wenke-chen/DM-segway/电气接线图.png

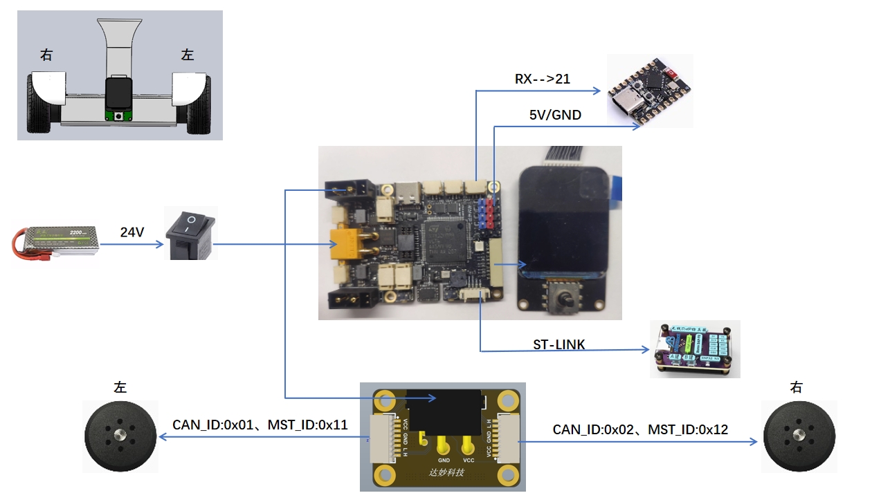
电气接线图.png
