wenke-chen/DM-segway/README.md

演示视频：[小米九号平衡车mini版](https://www.bilibili.com/video/BV1ERuzzHEXi/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)

相关教程：https://wenke-chen.github.io/p/segway/
