wenke-chen/DM-segway/DM-car-lqr/遥控说明.txt

esp32-c3mini参考：https://github.com/xiaocainiao11111/ESP32_connect_XboxController
接线： 21-->rx
