wenke-chen/DM-segway/平衡车BOM.xlsx

序号 | 物料类型 | 物料名称 | 物料型号 | 物料示意图 | 参数说明 | 单价 | 数量 | 总价 | 购买链接 | 备注
1 | 电子件 | 开发板 | DM_MC02 |  | 主控+LCD模块 | 235 | 1 | 235 | https://item.taobao.com/item.htm?id=814954787248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
2 | 电子件 | XT30 2+2 线缆 | XT30 2+2 |  | 200mm | 12 | 1 | 12 | https://item.taobao.com/item.htm?id=815810342495&skuId=5683518279285
3 | 电子件 | 转接板1 | 2×sh1.0-8pin转xt30 2+2 |  |  |  | 1 | 0 |  | 自己打板
4 | 电子件 | 转接板2 | sh1.0-3pin+8pin转xt30+gh1.25 |  |  |  | 1 | 0 | https://item.taobao.com/item.htm?abbucket=17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 | 转接板2用于上位机与电机单独调试
5 | 电子件 | 6s电池 | 1100ma/h 30C |  |  | 63 | 1 | 63 | https://item.taobao.com/item.htm?_u=b3gud67l3a33&id=527326501663&skuId=4922250528308 | 自备充电器
6 | 电子件 | ESP32-C3开发板 | ESP32-C3开发板 |  | wifi+蓝牙模块 4M闪存 | 11 | 1 | 11 | https://detail.tmall.com/item.htm?id=775162111731 | 接受手柄蓝牙信号
7 | 电子件 | DM-H3510电机 | DM-H3510电机 |  |  | 220 | 2 | 440 | https://item.taobao.com/item.htm?ft=t&id=871173947758 | 无USB转CAN模块的话需要买一个
8 | 电子件 | 无线仿真器下载器 | S3亚克力透明 |  | 一对/送typec线 | 76 | 1 | 76 | https://item.taobao.com/item.htm?id=742336811163
9 | 电子件 | 船型开关 | 黑色/2脚2档 |  |  | 0.28 | 1 | 0.28 | https://item.taobao.com/item.htm?abbucket=17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 | 自行焊接，套上热缩管
10 | 电子件 | XT60 | XT60-M（公头） |  |  | 1.6 | 1 | 1.6 | https://item.taobao.com/item.htm?id=599294573848&skuId=4184175637803 | 自行焊接，套上热缩管
11 | 电子件 | XT30 | XT30U-F（母头） |  |  | 1.76 | 1 | 1.76 | https://item.taobao.com/item.htm?id=599542302840 | 自行焊接，套上热缩管
12 | 电子件 | 特软硅胶线 (https://item.taobao.com/item.htm?id=885836732558) | 硅胶红黑线 2*18AWG 0.75平方;1m |  |  | 2.66 | 1 | 2.66 | https://item.taobao.com/item.htm?id=885836732558
13 | 电子件 | 转接线 | GH1.25带锁扣转2.54杜邦端子线-3P |  |  | 0.45 | 1 | 0.45 | https://item.taobao.com/item.htm?id=714564057090&skuId=5001796553557 | 串口通讯线
14 | 电子件 | 转接线 | GH1.25带锁扣转2.54杜邦端子线-4P |  |  | 0.62 | 1 | 0.62 | https://item.taobao.com/item.htm?id=714564057090&skuId=5001796553557 | 烧录线
15 | 电子件 | 启明星无线游戏手柄 | 启明星1辉光白 |  |  | 72 | 1 | 72 | https://detail.tmall.com/item.htm?id=749611763829
16 | 机械件 | 沉头螺丝 | M2.5*6[200只] |  |  | 3.3 | 1 | 3.3 | https://detail.tmall.com/item.htm?id=693377485791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
17 | 机械件 | 沉头螺丝 | M3*6【50个】 |  |  | 3.4 | 1 | 3.4 | https://detail.tmall.com/item.htm?id=693377485791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
18 | 机械件 | 沉头螺丝 | M3*10[50只] |  |  | 3.4 | 1 | 3.4 | https://detail.tmall.com/item.htm?id=693377485791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
19 | 机械件 | 轮胎 | 6017 4只 |  |  | 13.99 | 1 | 13.99 | https://item.taobao.com/item.htm?_u=c2085qbuhef74b&id=587868869562&skuId=4172131990287
20 | 3D打印件 | 底盘 |  |  |  |  | 1 | 50 |  | 自行打印
21 | 3D打印件 | 轮毂 |  |  |  |  | 2
22 | 3D打印件 | 电池底座 |  |  |  |  | 1
23 | 3D打印件 | 轮子水盖 |  |  |  |  | 2
24 | 3D打印件 | 上盖 |  |  |  |  | 1
 |  |  |  |  |  | 合计 |  | 990.46
