wenke-chen/DM-segway/3D打印/底盘.STEP

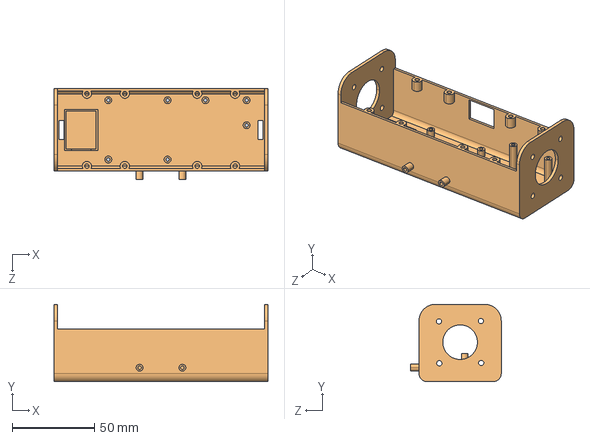
[picture p2: CAD file, 2025-07-14]
3D打印/底盘.STEP
130.0 x 47.0 x 55.0 mm
