wenke-chen/DM-segway/3D打印/轮毂.STEP

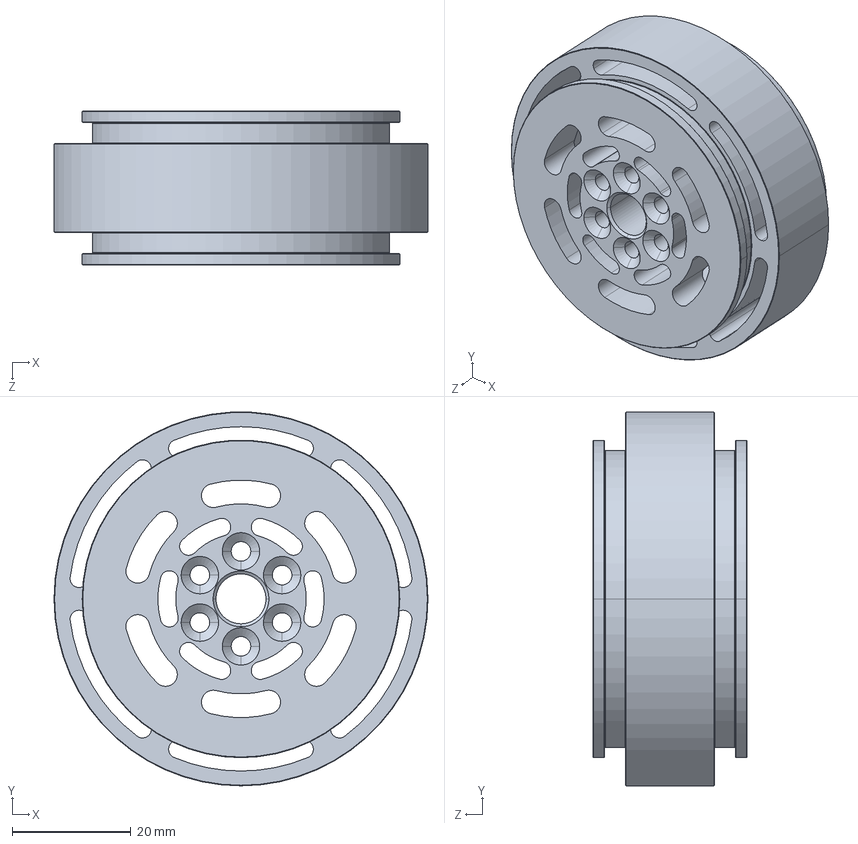
[picture p3: CAD file, 2025-07-13]
3D打印/轮毂.STEP
63.0 x 63.0 x 26.0 mm
