wenke-chen/DM-segway/3D打印/电池底座.STEP

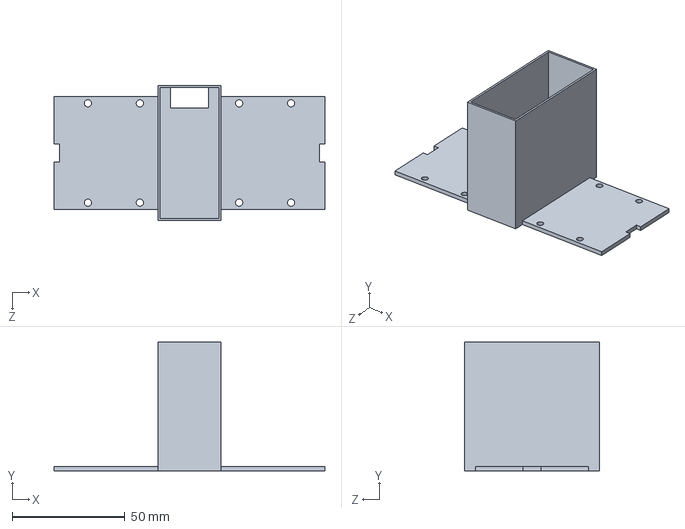
[picture p4: CAD file, 2025-07-13]
3D打印/电池底座.STEP
120.0 x 57.0 x 60.0 mm
