wenke-chen/DM-segway/3D打印/上盖.STEP

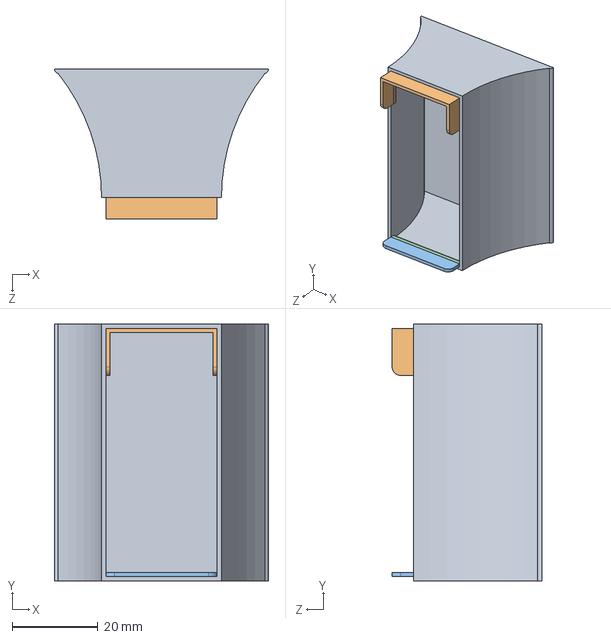
[picture p5: CAD file, 2025-07-13]
3D打印/上盖.STEP
50.0 x 60.0 x 35.0 mm
