wenke-chen/DM-segway/3D打印/轮子水盖.STEP

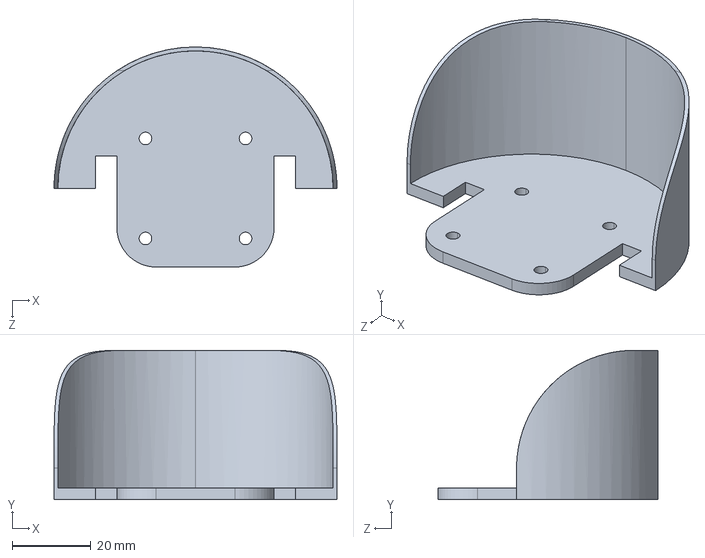
[picture p6: CAD file, 2025-07-13]
3D打印/轮子水盖.STEP
72.0 x 38.0 x 56.0 mm
