wenke-chen/DM-segway/DM-car-lqr/Core/Inc/main.h

#define ACC_CS_Pin GPIO_PIN_0
#define ACC_CS_GPIO_Port GPIOC
#define GYRO_CS_Pin GPIO_PIN_3
#define GYRO_CS_GPIO_Port GPIOC
#define DI_Pin GPIO_PIN_0
#define DI_GPIO_Port GPIOA
#define DO_Pin GPIO_PIN_2
#define DO_GPIO_Port GPIOA
#define CS_Pin GPIO_PIN_9
#define CS_GPIO_Port GPIOE
#define ACC_INT_Pin GPIO_PIN_10
#define ACC_INT_GPIO_Port GPIOE
#define GYRO_INT_Pin GPIO_PIN_12
#define GYRO_INT_GPIO_Port GPIOE
#define CLK_Pin GPIO_PIN_13
#define CLK_GPIO_Port GPIOE
#define LCD_CS_Pin GPIO_PIN_15
#define LCD_CS_GPIO_Port GPIOE
#define LCD_BLK_Pin GPIO_PIN_10
#define LCD_BLK_GPIO_Port GPIOB
#define LCD_RES_Pin GPIO_PIN_11
#define LCD_RES_GPIO_Port GPIOB
#define LCD_DC_Pin GPIO_PIN_10
#define LCD_DC_GPIO_Port GPIOD
